solideringroom/Medical_-Car/stm32/Core/Src/main.c

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
/* Includes ------------------------------------------------------------------*/
#include "main.h"

/* USER CODE BEGIN Includes */
#include "oled.h"
#include "IIC.h"
#include "inv_mpu.h"
#include "inv_mpu_dmp_motion_driver.h"
#include "mpu6050.h"
#include "stdio.h"
#include "soft_timer.h"
#include "TB6612.h"
#include "Encoder.h"
#include "car_control.h"
#include "Task_Machine.h"
#include "MV_UART.h"
/* USER CODE END Includes */

I2C_HandleTypeDef hi2c1;

TIM_HandleTypeDef htim1;
TIM_HandleTypeDef htim2;
TIM_HandleTypeDef htim4;
TIM_HandleTypeDef htim6;
TIM_HandleTypeDef htim8;

UART_HandleTypeDef huart5;
UART_HandleTypeDef huart2;
UART_HandleTypeDef huart3;

/* USER CODE BEGIN PV */
//串口通信变量：
uint8_t Openmv_Buff[100] = {0};
uint8_t Openmv_Recv_Data;

float distance_er,angle_er;

/* USER CODE END PV */

void SystemClock_Config(void);
static void MX_GPIO_Init(void);
static void MX_TIM1_Init(void);
static void MX_TIM2_Init(void);
static void MX_TIM4_Init(void);
static void MX_TIM8_Init(void);
static void MX_UART5_Init(void);
static void MX_USART2_UART_Init(void);
static void MX_USART3_UART_Init(void);
static void MX_I2C1_Init(void);
static void MX_TIM6_Init(void);
/* USER CODE BEGIN PFP */
void HAL_GPIO_EXTI_Callback(uint16_t GPIO_Pin)
{
	if(GPIO_Pin == GPIO_PIN_2)
	{
		HAL_GPIO_TogglePin(GPIOF,GPIO_PIN_6);
	}
}
void HAL_UART_RxCpltCallback(UART_HandleTypeDef *huart)
{
	if(huart == &huart2)
	{
		Decode(Openmv_Recv_Data,Recv_Buff);
		HAL_UART_Receive_IT(&huart2,&Openmv_Recv_Data,1);
	}
}
/* USER CODE END PFP */

/* USER CODE BEGIN 0 */
float pitch,roll,yaw;
char display_buff[20];
float M1_SPEED,M1_DISTANCE,M2_SPEED,M2_DISTANCE,ERROR_TREM,I_Out;
float SPEED_GOAL = 1;
float DISTANCE_GOAL = 8;
uint8_t KB1FLAG,KB2FLAG,KB3FLAG;
uint8_t DMP_FLAG,MPU_FLAG;
short Left_Motor_Speed_TEST,Right_Motor_Speed_TEST;


//PID
CarType Medicine_Car;
positional_pid_ctrler PID_M1_SPEED;
positional_pid_ctrler PID_M1_DISTANCE;
/* USER CODE END 0 */

/**
  * @brief  The application entry point.
  * @retval int
  */
int main(void)
{

  /* MCU Configuration--------------------------------------------------------*/

  /* Reset of all peripherals, Initializes the Flash interface and the Systick. */
  HAL_Init();

  /* Configure the system clock */
  SystemClock_Config();

  /* Initialize all configured peripherals */
  MX_GPIO_Init();
  MX_TIM1_Init();
  MX_TIM2_Init();
  MX_TIM4_Init();
  MX_TIM8_Init();
  MX_UART5_Init();
  MX_USART2_UART_Init();
  MX_USART3_UART_Init();
  MX_I2C1_Init();
  MX_TIM6_Init();
  /* USER CODE BEGIN 2 */
	OLED_Init();
	OLED_Clear();
	OLED_ShowString(0,0,(uint8_t*)"Hello",8);
	MPU_FLAG = MPU_Init();
	DMP_FLAG = mpu_dmp_init();
	sprintf(display_buff,"ERROR:%d,%d",MPU_FLAG,DMP_FLAG);
	OLED_ShowString(0,0,(uint8_t*)display_buff,8);
	Car_Init(&Medicine_Car);
	ERROR_EARSER_INIT();
	T_Data = '1';
	HAL_UART_Receive_IT(&huart2,&Openmv_Recv_Data,1); 

  /* USER CODE END 2 */

  /* Infinite loop */
  /* USER CODE BEGIN WHILE */
	uint8_t num0 = 0;
	uint8_t num1 = 0;
	uint8_t num2 = 0;
  float Left_speed_debug;
  float Right_speed_debug;
//	
	soft_timer_repeat_init(SOFT_TIMER_0,1000);
	soft_timer_repeat_init(SOFT_TIMER_1,200);
	soft_timer_repeat_init(SOFT_TIMER_2,1000);

  while (1)
  {
		if(soft_timer_is_timeout(SOFT_TIMER_0))
		{
			HAL_GPIO_TogglePin(GPIOF,GPIO_PIN_3);
			HAL_GPIO_TogglePin(GPIOF,GPIO_PIN_4);
			HAL_GPIO_TogglePin(GPIOF,GPIO_PIN_5);
		}
		if(soft_timer_is_timeout(SOFT_TIMER_1))
		{
			M1_DISTANCE = Get_M1_Distance();	
			sprintf(display_buff,"S1:%.2fD1:%.2f  ",M1_SPEED,M1_DISTANCE);
			OLED_ShowString(0,1,(uint8_t*)display_buff,8);
			M2_DISTANCE = Get_M2_Distance();	
			sprintf(display_buff,"S2:%.2fD2:%.2f  ",M2_SPEED,M2_DISTANCE);
			OLED_ShowString(0,2,(uint8_t*)display_buff,8);
			sprintf(display_buff,"MAIN_TASK:%d  ",Medicine_Car_Task);
			OLED_ShowString(0,3,(uint8_t*)display_buff,8);
			sprintf(display_buff,"STEP_TASK:%d  ",a_temp_step);
			OLED_ShowString(0,4,(uint8_t*)display_buff,8);
			sprintf(display_buff,"dx:%d,dy:%d     ",Recv_Buff[0],Recv_Buff[1]);
			OLED_ShowString(0,5,(uint8_t*)display_buff,8);
			sprintf(display_buff,"RECVOK?%d      ",recv_status);
			OLED_ShowString(0,6,(uint8_t*)display_buff,8);
      sprintf(display_buff,"Cross:%d ", Recv_Buff[2]);
      OLED_ShowString(0,7,(uint8_t*)display_buff,8);
		}
		if(soft_timer_is_timeout(SOFT_TIMER_2))
		{
			 
		}
    /* USER CODE END WHILE */

    /* USER CODE BEGIN 3 */
  }
  
  /* USER CODE END 3 */
}

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
