solideringroom/Medical_-Car/stm32/EE_PROJECT.ioc

Mcu.UserName=STM32F407ZGTx
PA1.Signal=S_TIM2_CH2
PA2.Signal=S_TIM2_CH3
PA3.Signal=USART2_RX
PB11.Signal=USART3_RX
PB6.Signal=I2C1_SCL
PB7.Signal=I2C1_SDA
PC0.Signal=GPIO_Output
PC12.Signal=UART5_TX
PC6.Signal=S_TIM8_CH1
PC7.Signal=S_TIM8_CH2
PD12.Signal=S_TIM4_CH1
PD13.Signal=S_TIM4_CH2
PD2.Signal=UART5_RX
PD5.Signal=USART2_TX
PD8.Signal=USART3_TX
PE0.Signal=GPIO_Output
PE1.Signal=GPIO_Output
PE11.Signal=S_TIM1_CH2
PE13.Signal=S_TIM1_CH3
PE2.Signal=GPXTI2
PE3.Signal=GPXTI3
PE5.Signal=GPXTI5
PE7.Signal=GPIO_Output
PE9.Signal=S_TIM1_CH1
PF0.Signal=GPIO_Output
PF1.Signal=GPIO_Output
PF3.Signal=GPIO_Output
PF4.Signal=GPIO_Output
PF5.Signal=GPIO_Output
PF6.Signal=GPIO_Output
PG13.Signal=GPIO_Input
PH0-OSC_IN.Signal=RCC_OSC_IN
PH1-OSC_OUT.Signal=RCC_OSC_OUT
