solideringroom/Medical_-Car/(commit log)

2025-06-13 添加了openmv一些代码
2025-06-14 6.14完善了视觉和32之间的数据传输和相互通信
2025-06-15 寻线程序
2025-06-16 [feat] 完善巡线程序，实现基础走直线
2025-06-16 完成了第一个基础任务
2025-06-16 完成第一个基础任务
2025-06-17 实现了指哪打哪，但是参数还得微调，速度得上去
